joewa/open-bldc-hardware/strip/v0.2/pictures/strip_V02-bottom.jpg

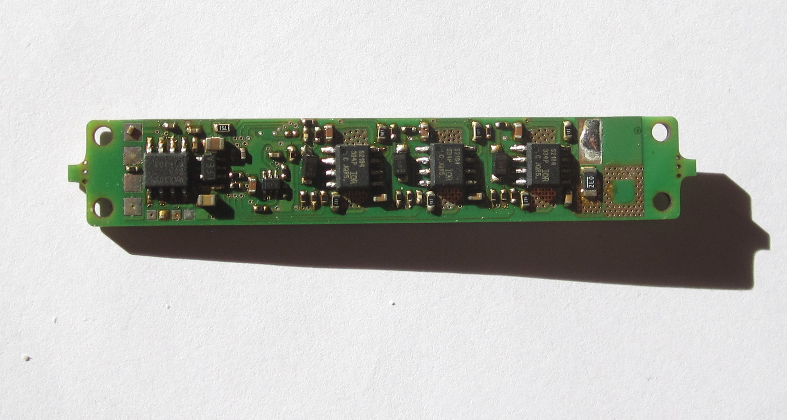
strip/v0.2/pictures/strip_V02-bottom.jpg
