joewa/open-bldc-hardware/strip/v0.2/strip.brd

## EAGLE design strip/v0.2/strip.brd (2014-05-27)

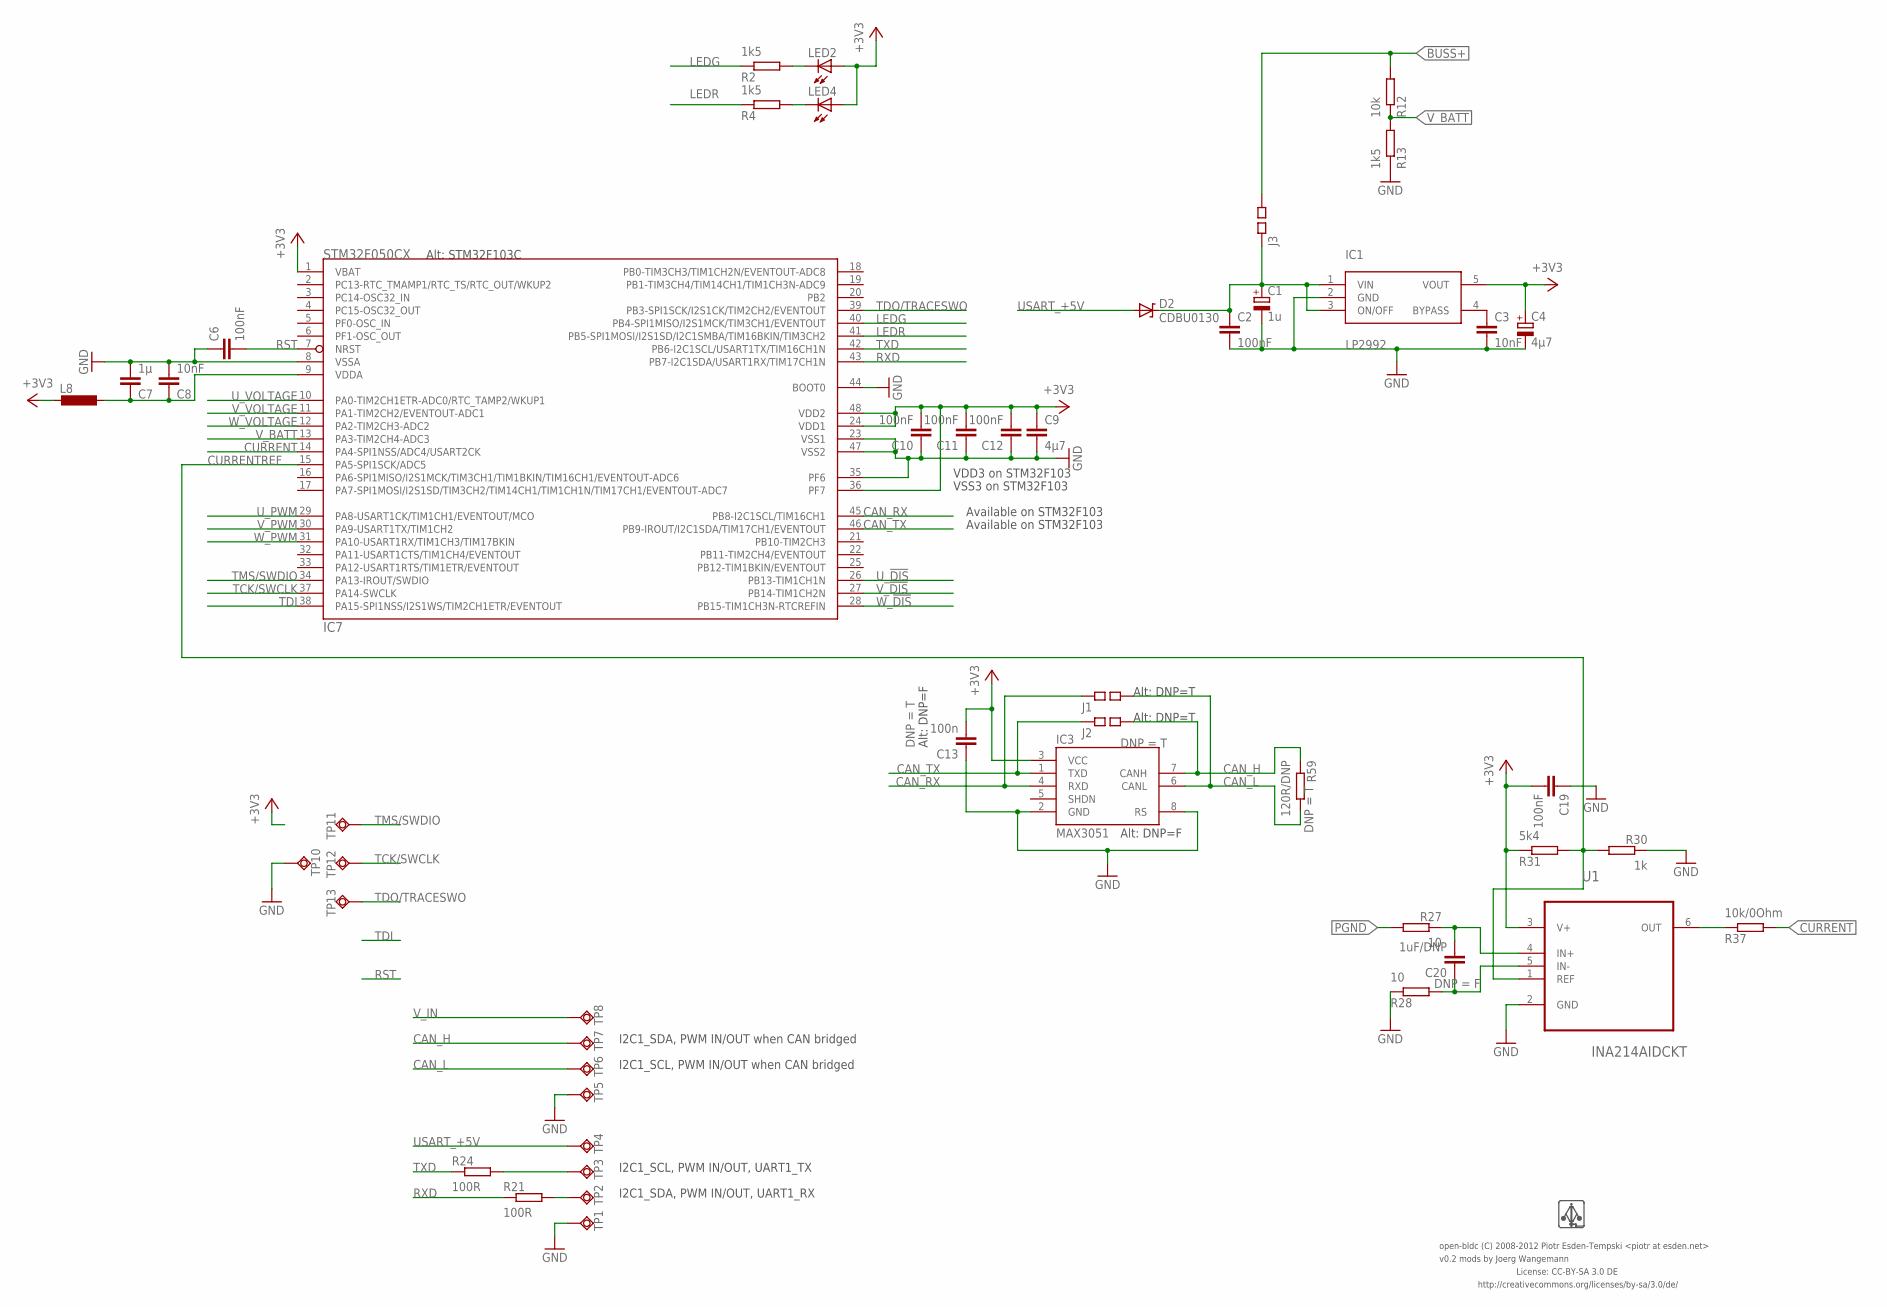
[picture p3: schematic strip.sch, sheet 1]

Parts:
C1: 1u; 0805-POL-CAP; PARTNO cap-cer-0805-1u-35v
C2, C6, C10, C11, C12, C19: 100nF; 0402-CAP; PARTNO cap-cer-0402-100n
C3, C8: 10nF; 0402-CAP; PARTNO cap-cer-0402-10n
C4: 4µ7; 0805-POL-CAP; PARTNO cap-cer-0805-4u7-16v
C7: 1µ; 0402-CAP; PARTNO cap-cer-0402-1u
C9: 4µ7; 0805-CAP; PARTNO cap-cer-0805-4u7
C13: 100n; 0402-CAP; PARTNO cap-cer-0402-100n
C20: 1uF/DNP; 0603-CAP; PARTNO cap-cer-0402-100n
D2: CDBU0130; 0603-DIO; PARTNO diode-0603
IC1: LP2992; SOT23-5; PARTNO vreg-sot-23-5-3v3
IC3: MAX3051; SO8; PARTNO *
IC7: STM32F050CX; LQFP48; PARTNO mcu-tqfp-32-stm32f05
J1, J2, J3: SQ_JMP-0402; 0402-SQJMP; PARTNO res-0402-0
L8: INDUCTOR-0603; 0603-IND; PARTNO ferrite-0603-600ohm
LED2: GREEN; 0402-LED; PARTNO led-0402-green
LED4: RED; 0402-LED; PARTNO led-0402-green
R2, R4, R13: 1k5; 0402-RES; PARTNO res-0402-1k5
R12: 10k; 0402-RES; PARTNO res-0402-10k
R21, R24: 100R; 0402-RES; PARTNO res-0402-100
R27: 10; 0402-RES; PARTNO res-0402-665
R28: 10; 0402-RES; PARTNO res-0402-560
R30: 1k; 0402-RES; PARTNO res-0402-1k
R31: 5k4; 0402-RES; PARTNO res-0402-5k36
R37: 10k/0Ohm; 0402-RES; PARTNO res-0402-0
R59: 120R/DNP; 0402-RES; PARTNO res-0402-60.4
TP1, TP2, TP3, TP4, TP5, TP6, TP7, TP8: TPSQTP20SQ; TP20SQ; PARTNO *
TP10, TP11, TP12, TP13: TPSQTP11SQ; TP11SQ; PARTNO *
U1: INA214AIDCKT; SOT65P210X110-6N
U$1: LOGO; LOGO_SILK_SMALL; PARTNO *

Connections:
+3V3: C4.+, C9.P$1 (1), C10.P$2 (2), C11.P$2 (2), C12.P$2 (2), C13.P$2 (2), C19.P$2 (2), IC1.5 (VOUT), IC3.3 (VCC), IC7.1 (VBAT), IC7.24 (VDD1), IC7.36 (PF7), IC7.48 (VDD2), L8.P$2 (2), LED2.A, LED4.A, R31.P$1 (1), U1.3 (V+)
BUSS+: J3.P$2 (2), R12.P$2 (2); also elsewhere on the board
CAN_H: IC3.7 (CANH), J2.P$2 (2), R59.P$1 (1), TP7.TP
CAN_L: IC3.6 (CANL), J1.P$2 (2), R59.P$2 (2), TP6.TP
CAN_RX: IC3.4 (RXD), IC7.45 (PB8-I2C1SCL/TIM16CH1), J1.P$1 (1)
CAN_TX: IC3.1 (TXD), IC7.46 (PB9-IROUT/I2C1SDA/TIM17CH1/EVENTOUT), J2.P$1 (1)
CURRENT: IC7.14 (PA4-SPI1NSS/ADC4/USART2CK), R37.P$2 (2)
CURRENTREF: IC7.15 (PA5-SPI1SCK/ADC5), R30.P$2 (2), R31.P$2 (2), U1.1 (REF)
CURRENT_RAW: R37.P$1 (1), U1.6 (OUT)
GND: C1.-, C2.P$2 (2), C3.P$2 (2), C4.-, C6.P$1 (1), C7.P$2 (2), C8.P$2 (2), C9.P$2 (2), C10.P$1 (1), C11.P$1 (1), C12.P$1 (1), C13.P$1 (1), C19.P$1 (1), IC1.2 (GND), IC3.2 (GND), IC3.8 (RS), IC7.8 (VSSA), IC7.23 (VSS1), IC7.35 (PF6), IC7.44 (BOOT0), IC7.47 (VSS2), R13.P$1 (1), R28.P$1 (1), R30.P$1 (1), TP1.TP, TP5.TP, TP10.TP, U1.2 (GND); also elsewhere on the board
INA21_INN: C20.P$1 (1), R28.P$2 (2), U1.5 (IN-)
INA21_INP: C20.P$2 (2), R27.P$1 (1), U1.4 (IN+)
LEDG: IC7.40 (PB4-SPI1MISO/I2S1MCK/TIM3CH1/EVENTOUT), R2.P$1 (1)
LEDR: IC7.41 (PB5-SPI1MOSI/I2S1SD/I2C1SMBA/TIM16BKIN/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), R4.P$1 (1)
unnamed: LED4.C, R4.P$2 (2)
unnamed: R21.P$2 (2), TP2.TP
unnamed: LED2.C, R2.P$2 (2)
unnamed: R24.P$2 (2), TP3.TP
unnamed: C3.P$1 (1), IC1.4 (BYPASS)
PGND: R27.P$2 (2); also elsewhere on the board
RST: C6.P$2 (2), IC7.7 (NRST)
RXD: IC7.43 (PB7-I2C1SDA/USART1RX/TIM17CH1N), R21.P$1 (1)
TCK/SWCLK: IC7.37 (PA14-SWCLK), TP12.TP
TDI: IC7.38 (PA15-SPI1NSS/I2S1WS/TIM2CH1ETR/EVENTOUT)
TDO/TRACESWO: IC7.39 (PB3-SPI1SCK/I2S1CK/TIM2CH2/EVENTOUT), TP13.TP
TMS/SWDIO: IC7.34 (PA13-IROUT/SWDIO), TP11.TP
TXD: IC7.42 (PB6-I2C1SCL/USART1TX/TIM16CH1N), R24.P$1 (1)
USART_+5V: D2.A, TP4.TP
U_!DIS: IC7.26 (PB13-TIM1CH1N); also elsewhere on the board
U_PWM: IC7.29 (PA8-USART1CK/TIM1CH1/EVENTOUT/MCO); also elsewhere on the board
U_VOLTAGE: IC7.10 (PA0-TIM2CH1ETR-ADC0/RTC_TAMP2/WKUP1); also elsewhere on the board
VDDA: C7.P$1 (1), C8.P$1 (1), IC7.9 (VDDA), L8.P$1 (1)
V_!DIS: IC7.27 (PB14-TIM1CH2N); also elsewhere on the board
V_BATT: IC7.13 (PA3-TIM2CH4-ADC3), R12.P$1 (1), R13.P$2 (2)
V_IN: C1.+, C2.P$1 (1), D2.C, IC1.1 (VIN), IC1.3 (ON/OFF), J3.P$1 (1), TP8.TP
V_PWM: IC7.30 (PA9-USART1TX/TIM1CH2); also elsewhere on the board
V_VOLTAGE: IC7.11 (PA1-TIM2CH2/EVENTOUT-ADC1); also elsewhere on the board
W_!DIS: IC7.28 (PB15-TIM1CH3N-RTCREFIN); also elsewhere on the board
W_PWM: IC7.31 (PA10-USART1RX/TIM1CH3/TIM17BKIN); also elsewhere on the board
W_VOLTAGE: IC7.12 (PA2-TIM2CH3-ADC2); also elsewhere on the board

Notes on the sheet:
License: CC-BY-SA 3.0 DE
http://creativecommons.org/licenses/by-sa/3.0/de/
open-bldc (C) 2008-2012 Piotr Esden-Tempski <piotr at esden.net>
VDD3 on STM32F103
VSS3 on STM32F103
Available on STM32F103
Alt: STM32F103C
Alt: DNP=T
Alt: DNP=F
I2C1_SDA, PWM IN/OUT when CAN bridged
I2C1_SCL, PWM IN/OUT when CAN bridged
I2C1_SCL, PWM IN/OUT, UART1_TX
I2C1_SDA, PWM IN/OUT, UART1_RX
v0.2 mods by Joerg Wangemann

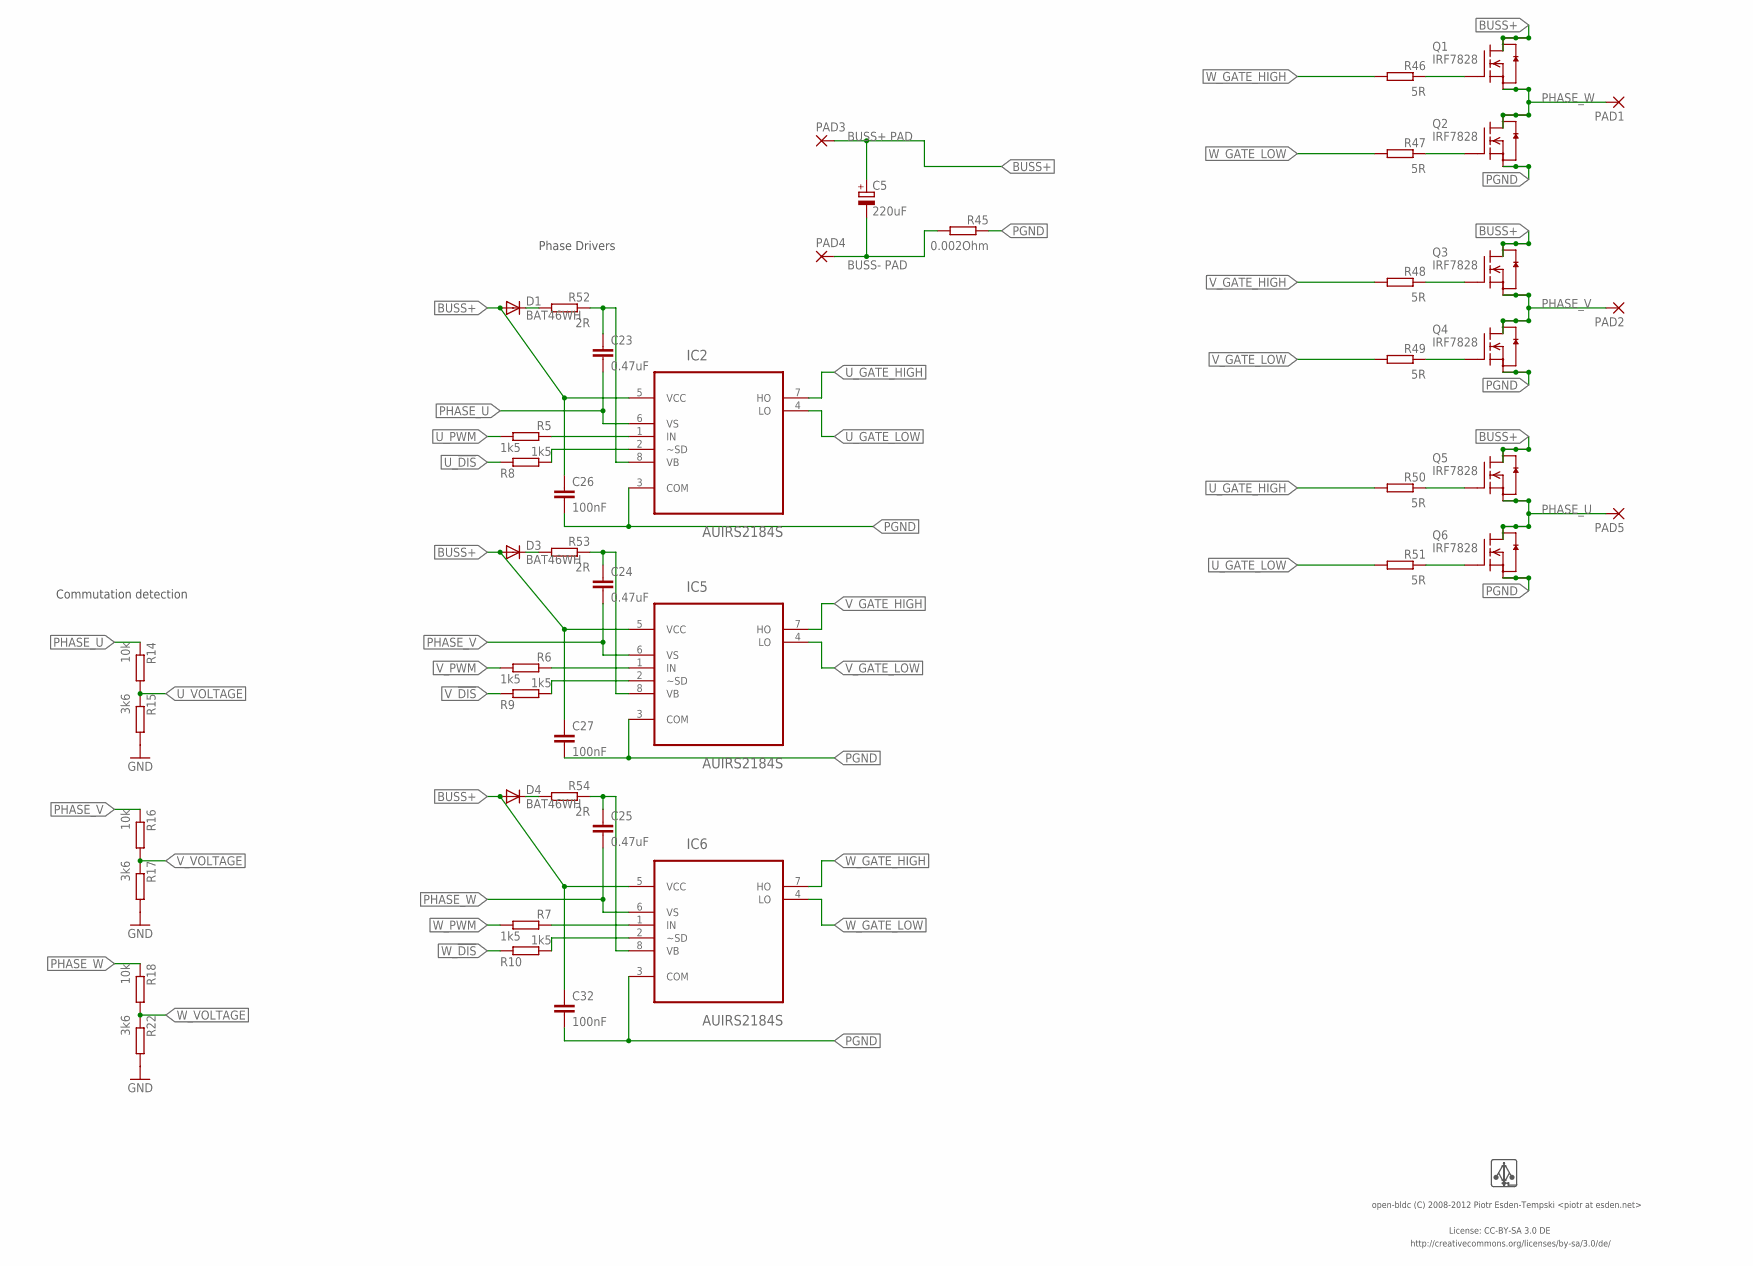
[picture p4: schematic strip.sch, sheet 2]

Parts:
C5: 220uF; 7343/D; PARTNO cap-tan-D-220u-16v
C23, C24, C25: 0.47uF; 0603-CAP; PARTNO cap-tan-0603-1u
C26, C27, C32: 100nF; 0603-CAP; PARTNO cap-cer-0402-100n
D1, D3, D4: BAT46WH; SOD-123-DIO; PARTNO *
IC2, IC5, IC6: AUIRS2184S; SOIC127P600X175-8N; PARTNO ic-so8-mosfet-driver-buck
PAD1, PAD2, PAD3, PAD4, PAD5: SMD5; SMD2,54-5,08; PARTNO *
Q1, Q2, Q3, Q4, Q5, Q6: IRF7828; SO8; PARTNO ic-so8-mosfet-n-ch-30v-15a
R5, R6, R7, R8, R9, R10: 1k5; 0402-RES; PARTNO res-0402-1k5
R14, R16, R18: 10k; 0402-RES; PARTNO res-0402-10k
R15, R17, R22: 3k6; 0402-RES; PARTNO *
R45: 0.002Ohm; 1206-RES; PARTNO res-1206-0005
R46, R47, R48, R49, R50, R51: 5R; 0603-RES; PARTNO res-0402-10
R52, R53, R54: 2R; 0402-RES; PARTNO res-0402-10
U$2: LOGO; LOGO_SILK_SMALL; PARTNO *

Connections:
BUSS+: C5.+, C26.P$1 (1), C27.P$1 (1), C32.P$1 (1), D1.A, D3.A, D4.A, IC2.5 (VCC), IC5.5 (VCC), IC6.5 (VCC), PAD3.1, Q1.5 (D1), Q1.6 (D2), Q1.7 (D3), Q1.8 (D4), Q3.5 (D1), Q3.6 (D2), Q3.7 (D3), Q3.8 (D4), Q5.5 (D1), Q5.6 (D2), Q5.7 (D3), Q5.8 (D4); also elsewhere on the board
GND: C5.-, PAD4.1, R15.P$2 (2), R17.P$2 (2), R22.P$2 (2), R45.P$2 (2); also elsewhere on the board
unnamed: D1.C, R52.P$2 (2)
unnamed: D4.C, R54.P$2 (2)
unnamed: D3.C, R53.P$2 (2)
PGND: C26.P$2 (2), C27.P$2 (2), C32.P$2 (2), IC2.3 (COM), IC5.3 (COM), IC6.3 (COM), Q2.1 (S3), Q2.2 (S2), Q2.3 (S1), Q4.1 (S3), Q4.2 (S2), Q4.3 (S1), Q6.1 (S3), Q6.2 (S2), Q6.3 (S1), R45.P$1 (1); also elsewhere on the board
PHASE_U: C23.P$2 (2), IC2.6 (VS), PAD5.1, Q5.1 (S3), Q5.2 (S2), Q5.3 (S1), Q6.5 (D1), Q6.6 (D2), Q6.7 (D3), Q6.8 (D4), R14.P$1 (1)
PHASE_V: C24.P$2 (2), IC5.6 (VS), PAD2.1, Q3.1 (S3), Q3.2 (S2), Q3.3 (S1), Q4.5 (D1), Q4.6 (D2), Q4.7 (D3), Q4.8 (D4), R16.P$1 (1)
PHASE_W: C25.P$2 (2), IC6.6 (VS), PAD1.1, Q1.1 (S3), Q1.2 (S2), Q1.3 (S1), Q2.5 (D1), Q2.6 (D2), Q2.7 (D3), Q2.8 (D4), R18.P$1 (1)
U_!DIS: R8.P$1 (1); also elsewhere on the board
U_GATE_HIGH: IC2.7 (HO), R50.P$2 (2)
U_GATE_HIGH_T: Q5.4 (G), R50.P$1 (1)
U_GATE_LOW: IC2.4 (LO), R51.P$2 (2)
U_GATE_LOW_T: Q6.4 (G), R51.P$1 (1)
U_PWM: R5.P$2 (2); also elsewhere on the board
U_PWM_IN: IC2.1 (IN), R5.P$1 (1)
U_SD: IC2.2 (~SD), R8.P$2 (2)
U_VB: C23.P$1 (1), IC2.8 (VB), R52.P$1 (1)
U_VOLTAGE: R14.P$2 (2), R15.P$1 (1); also elsewhere on the board
V_!DIS: R9.P$1 (1); also elsewhere on the board
V_GATE_HIGH: IC5.7 (HO), R48.P$2 (2)
V_GATE_HIGH_T: Q3.4 (G), R48.P$1 (1)
V_GATE_LOW: IC5.4 (LO), R49.P$2 (2)
V_GATE_LOW_T: Q4.4 (G), R49.P$1 (1)
V_PWM: R6.P$2 (2); also elsewhere on the board
V_PWM_IN: IC5.1 (IN), R6.P$1 (1)
V_SD: IC5.2 (~SD), R9.P$2 (2)
V_VB: C24.P$1 (1), IC5.8 (VB), R53.P$1 (1)
V_VOLTAGE: R16.P$2 (2), R17.P$1 (1); also elsewhere on the board
W_!DIS: R10.P$1 (1); also elsewhere on the board
W_GATE_HIGH: IC6.7 (HO), R46.P$2 (2)
W_GATE_HIGH_T: Q1.4 (G), R46.P$1 (1)
W_GATE_LOW: IC6.4 (LO), R47.P$2 (2)
W_GATE_LOW_T: Q2.4 (G), R47.P$1 (1)
W_PWM: R7.P$2 (2); also elsewhere on the board
W_PWM_IN: IC6.1 (IN), R7.P$1 (1)
W_SD: IC6.2 (~SD), R10.P$2 (2)
W_VB: C25.P$1 (1), IC6.8 (VB), R54.P$1 (1)
W_VOLTAGE: R18.P$2 (2), R22.P$1 (1); also elsewhere on the board

Notes on the sheet:
Phase Drivers
Commutation detection
BUSS+ PAD
BUSS- PAD
License: CC-BY-SA 3.0 DE
http://creativecommons.org/licenses/by-sa/3.0/de/
open-bldc (C) 2008-2012 Piotr Esden-Tempski <piotr at esden.net>

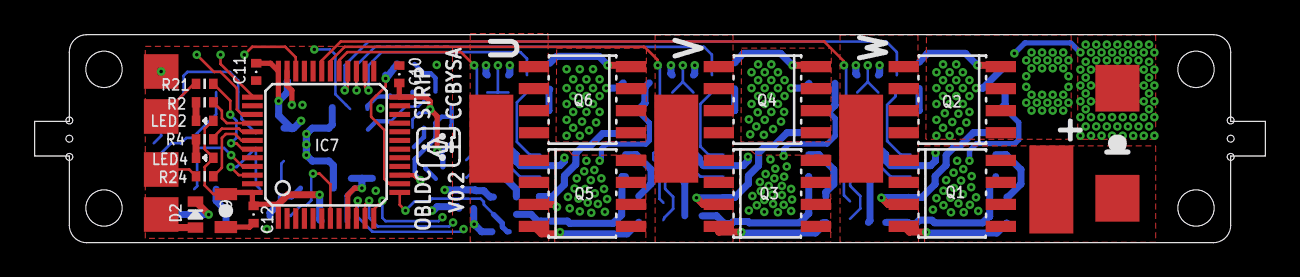
[picture p5: board strip.brd from above]

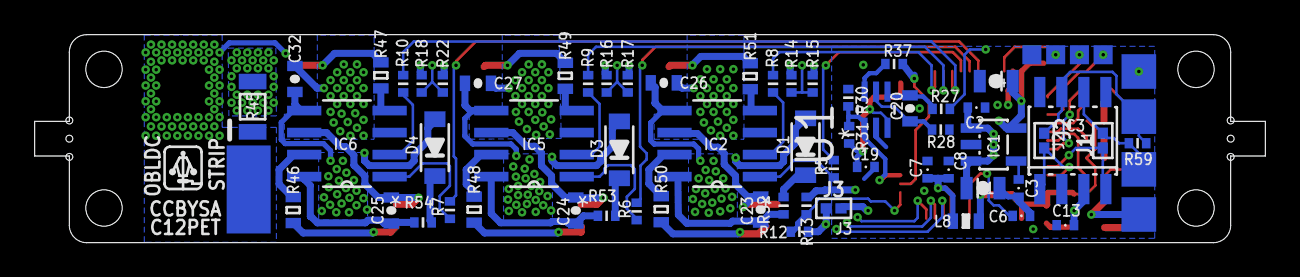
[picture p6: board strip.brd from below]

Board: 4 copper layers, 71.0 x 12.0 mm, 97 parts (69 on the bottom side), 66 nets.
