joewa/open-bldc-hardware/v0.3/power_hv/power.brd

## EAGLE design v0.3/power_hv/power.brd (2013-10-07)

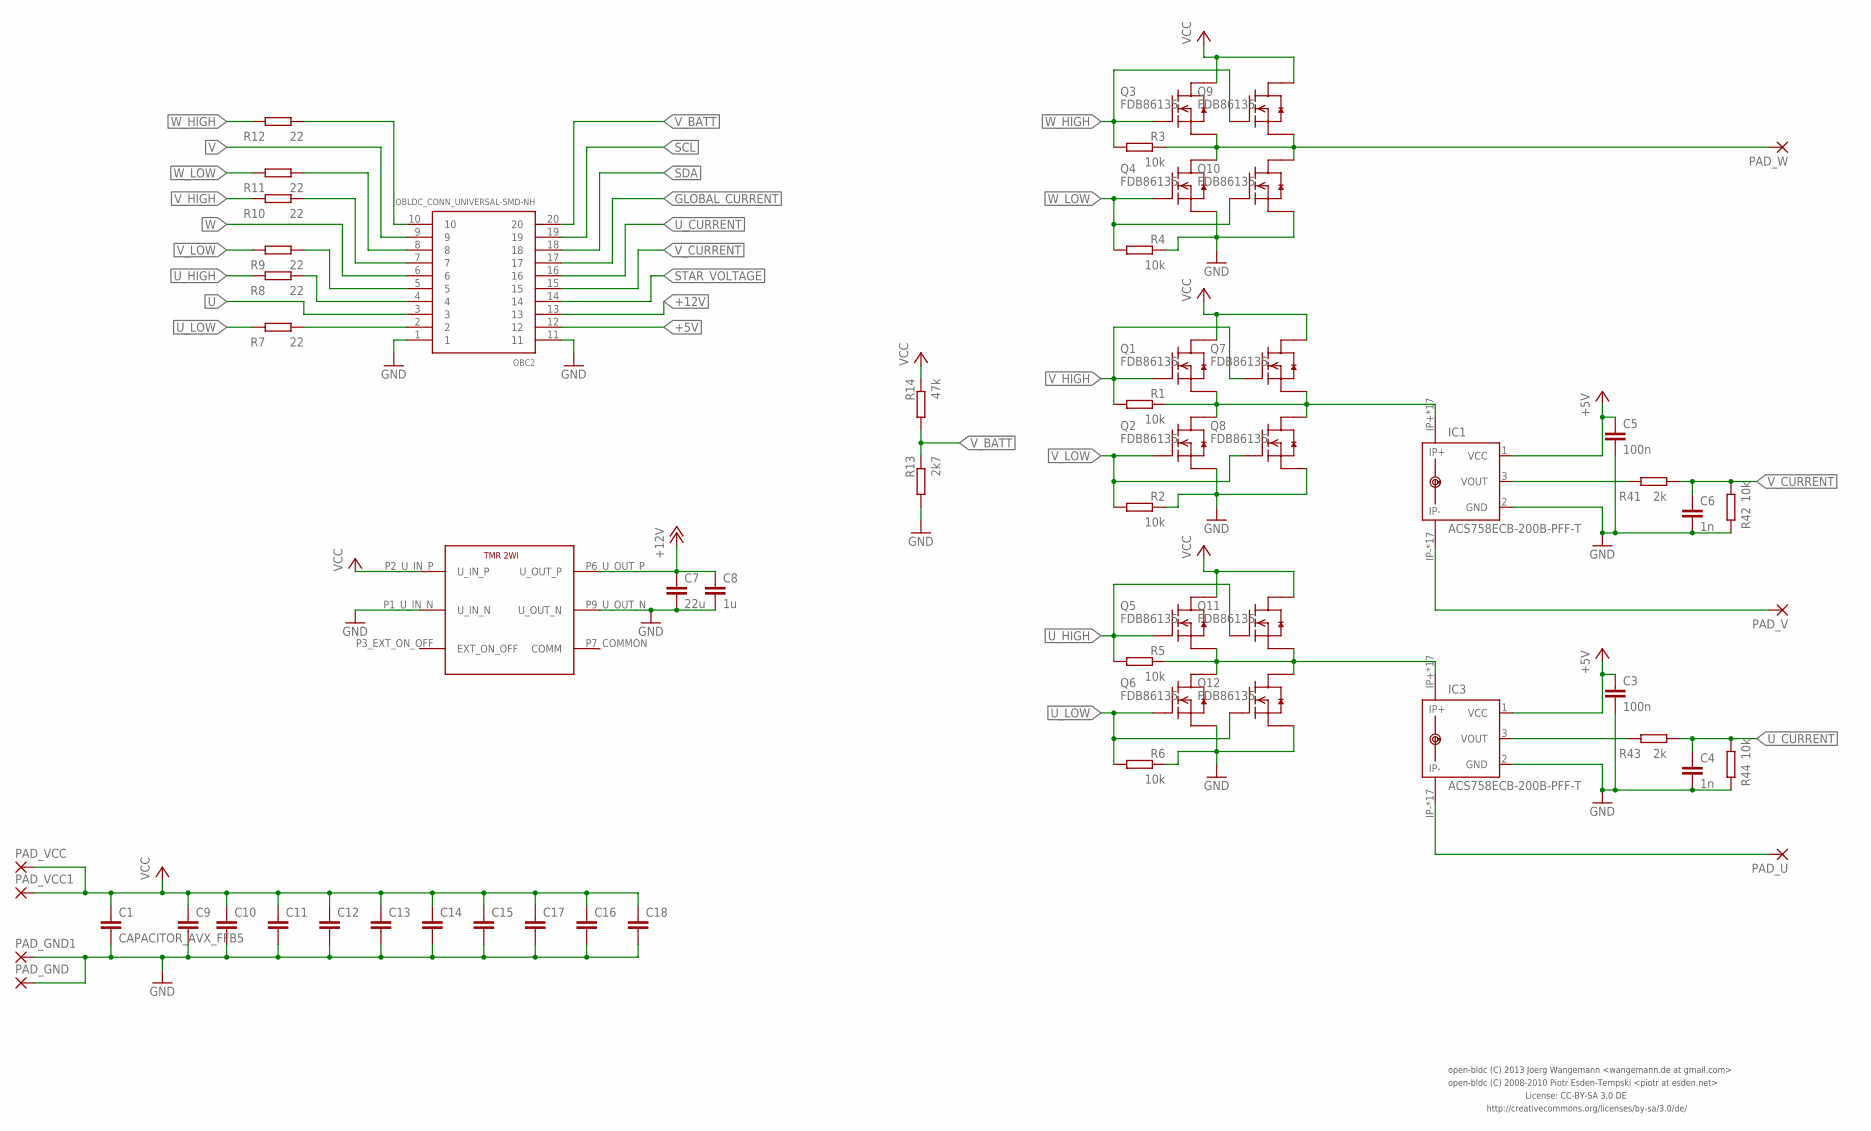
[picture p7: schematic power.sch]

Parts:
C1: CAPACITOR_AVX_FFB5; AVX_FFB5
C3, C5: 100n; 0603-CAP
C4, C6: 1n; 0603-CAP
C7: 22u; C2220K
C8: 1u; C1206
C9, C10, C11, C12, C13, C14, C15, C16, C17, C18: C-EUC2220K; C2220K
IC1, IC3: ACS758ECB-200B-PFF-T; CB-PFF
OBC2: OBLDC_CONN_UNIVERSAL-SMD-NH; OBLDC_CONN_SMD_NO_HOLES
PAD_GND, PAD_GND1: WIREPAD-2MM; WIREPAD_2MM
PAD_U: WIREPAD-2MM; WIREPAD_2MM
PAD_V: WIREPAD-2MM; WIREPAD_2MM
PAD_VCC, PAD_VCC1: WIREPAD-2MM; WIREPAD_2MM
PAD_W: WIREPAD-2MM; WIREPAD_2MM
Q1, Q2, Q3, Q4, Q5, Q6, Q7, Q8, Q9, Q10, Q11, Q12: FDB86135; DPAK
R1, R2, R3, R4, R5, R6: 10k; 0603-SF-RES
R7, R8, R9, R10, R11, R12: 22; 1206-RES
R13: 2k7; 1206-RES
R14: 47k; 1206-RES
R41, R43: 2k; 0603-RES
R42, R44: 10k; 0603-RES
U$2: TRACO_TMR_2WI

Connections:
+5V: C3.P$1 (1), C5.P$1 (1), IC1.1 (VCC), IC3.1 (VCC), OBC2.12
+12V: C7.1, C8.1, OBC2.13, U$2.P6_U_OUT_P (U_OUT_P)
GLOBAL_CURRENT: OBC2.17
GND: C1.P$2 (2), C3.P$2 (2), C4.P$2 (2), C5.P$2 (2), C6.P$2 (2), C7.2, C8.2, C9.2, C10.2, C11.2, C12.2, C13.2, C14.2, C15.2, C16.2, C17.2, C18.2, IC1.2 (GND), IC3.2 (GND), OBC2.1, OBC2.11, PAD_GND.1, PAD_GND1.1, Q2.3 (S), Q4.3 (S), Q6.3 (S), Q8.3 (S), Q10.3 (S), Q12.3 (S), R2.1, R4.1, R6.1, R13.P$2 (2), R42.P$2 (2), R44.P$2 (2), U$2.P1_U_IN_N (U_IN_N), U$2.P9_U_OUT_N (U_OUT_N)
unnamed: IC1.3 (VOUT), R41.P$2 (2)
unnamed: OBC2.2, R7.P$1 (1)
unnamed: OBC2.4, R8.P$1 (1)
unnamed: OBC2.5, R9.P$1 (1)
unnamed: OBC2.7, R10.P$1 (1)
unnamed: OBC2.8, R11.P$1 (1)
unnamed: OBC2.10, R12.P$1 (1)
unnamed: IC3.3 (VOUT), R43.P$2 (2)
SCL: OBC2.19
SDA: OBC2.18
STAR_VOLTAGE: OBC2.14
U: IC3.IP+, IC3.IP+@2 (IP+), IC3.IP+@3 (IP+), IC3.IP+@4 (IP+), IC3.IP+@5 (IP+), IC3.IP+@6 (IP+), IC3.IP+@7 (IP+), IC3.IP+@8 (IP+), IC3.IP+@9 (IP+), IC3.IP+@10 (IP+), IC3.IP+@11 (IP+), IC3.IP+@12 (IP+), IC3.IP+@13 (IP+), IC3.IP+@14 (IP+), IC3.IP+@15 (IP+), IC3.IP+@16 (IP+), IC3.IP+@17 (IP+), OBC2.3, Q5.3 (S), Q6.P$1 (D), Q11.3 (S), Q12.P$1 (D), R5.1
U_CURRENT: C4.P$1 (1), OBC2.16, R43.P$1 (1), R44.P$1 (1)
U_HIGH: Q5.1 (G), Q11.1 (G), R5.2, R8.P$2 (2)
U_LOW: Q6.1 (G), Q12.1 (G), R6.2, R7.P$2 (2)
U_PAD: IC3.IP-, IC3.IP-@2 (IP-), IC3.IP-@3 (IP-), IC3.IP-@4 (IP-), IC3.IP-@5 (IP-), IC3.IP-@6 (IP-), IC3.IP-@7 (IP-), IC3.IP-@8 (IP-), IC3.IP-@9 (IP-), IC3.IP-@10 (IP-), IC3.IP-@11 (IP-), IC3.IP-@12 (IP-), IC3.IP-@13 (IP-), IC3.IP-@14 (IP-), IC3.IP-@15 (IP-), IC3.IP-@16 (IP-), IC3.IP-@17 (IP-), PAD_U.1
V: IC1.IP+, IC1.IP+@2 (IP+), IC1.IP+@3 (IP+), IC1.IP+@4 (IP+), IC1.IP+@5 (IP+), IC1.IP+@6 (IP+), IC1.IP+@7 (IP+), IC1.IP+@8 (IP+), IC1.IP+@9 (IP+), IC1.IP+@10 (IP+), IC1.IP+@11 (IP+), IC1.IP+@12 (IP+), IC1.IP+@13 (IP+), IC1.IP+@14 (IP+), IC1.IP+@15 (IP+), IC1.IP+@16 (IP+), IC1.IP+@17 (IP+), OBC2.9, Q1.3 (S), Q2.P$1 (D), Q7.3 (S), Q8.P$1 (D), R1.1
VCC: C1.P$1 (1), C9.1, C10.1, C11.1, C12.1, C13.1, C14.1, C15.1, C16.1, C17.1, C18.1, PAD_VCC.1, PAD_VCC1.1, Q1.P$1 (D), Q3.P$1 (D), Q5.P$1 (D), Q7.P$1 (D), Q9.P$1 (D), Q11.P$1 (D), R14.P$1 (1), U$2.P2_U_IN_P (U_IN_P)
V_BATT: OBC2.20, R13.P$1 (1), R14.P$2 (2)
V_CURRENT: C6.P$1 (1), OBC2.15, R41.P$1 (1), R42.P$1 (1)
V_HIGH: Q3.1 (G), Q9.1 (G), R3.2, R10.P$2 (2)
V_LOW: Q4.1 (G), Q10.1 (G), R4.2, R9.P$2 (2)
V_PAD: IC1.IP-, IC1.IP-@2 (IP-), IC1.IP-@3 (IP-), IC1.IP-@4 (IP-), IC1.IP-@5 (IP-), IC1.IP-@6 (IP-), IC1.IP-@7 (IP-), IC1.IP-@8 (IP-), IC1.IP-@9 (IP-), IC1.IP-@10 (IP-), IC1.IP-@11 (IP-), IC1.IP-@12 (IP-), IC1.IP-@13 (IP-), IC1.IP-@14 (IP-), IC1.IP-@15 (IP-), IC1.IP-@16 (IP-), IC1.IP-@17 (IP-), PAD_V.1
W: OBC2.6, PAD_W.1, Q3.3 (S), Q4.P$1 (D), Q9.3 (S), Q10.P$1 (D), R3.1
W_HIGH: Q1.1 (G), Q7.1 (G), R1.2, R12.P$2 (2)
W_LOW: Q2.1 (G), Q8.1 (G), R2.2, R11.P$2 (2)

Notes on the sheet:
License: CC-BY-SA 3.0 DE
http://creativecommons.org/licenses/by-sa/3.0/de/
open-bldc (C) 2008-2010 Piotr Esden-Tempski <piotr at esden.net>
open-bldc (C) 2013 Joerg Wangemann <wangemann.de at gmail.com>

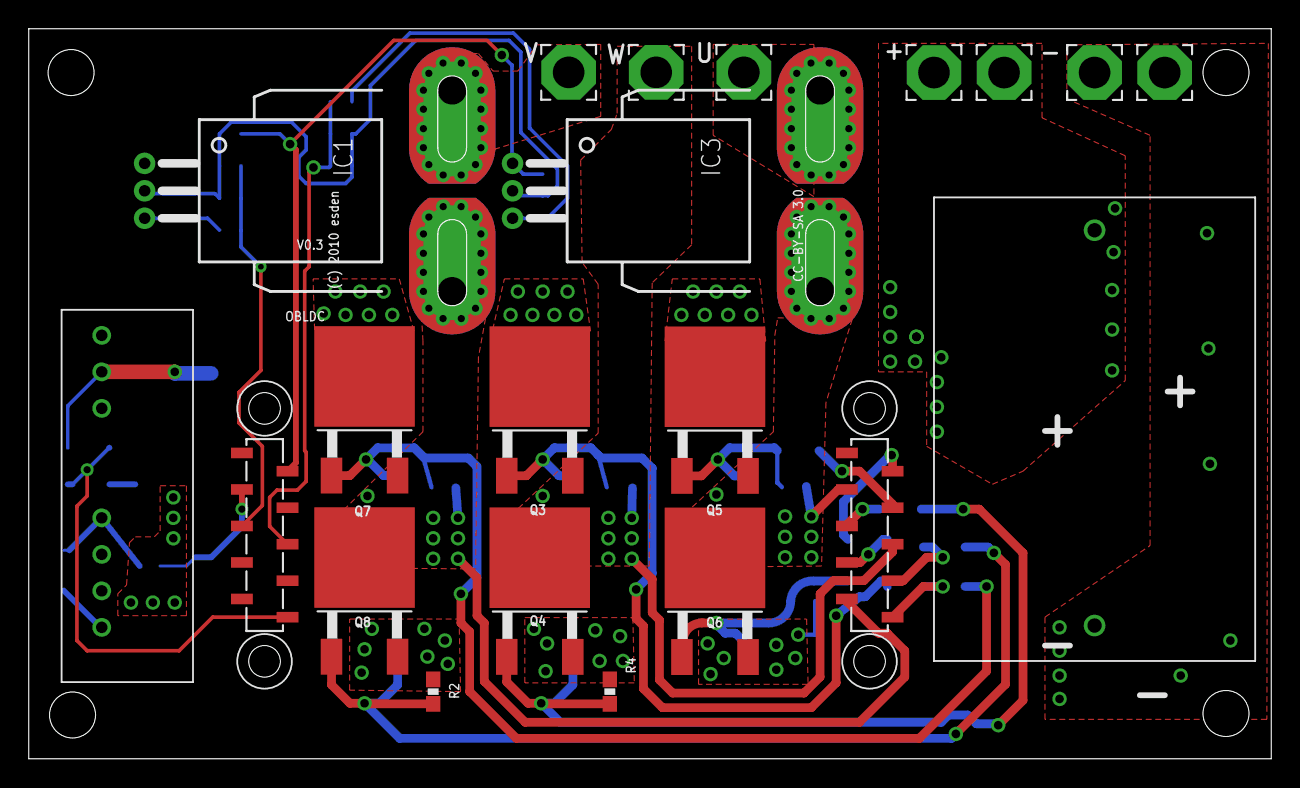
[picture p8: board power.brd from above]

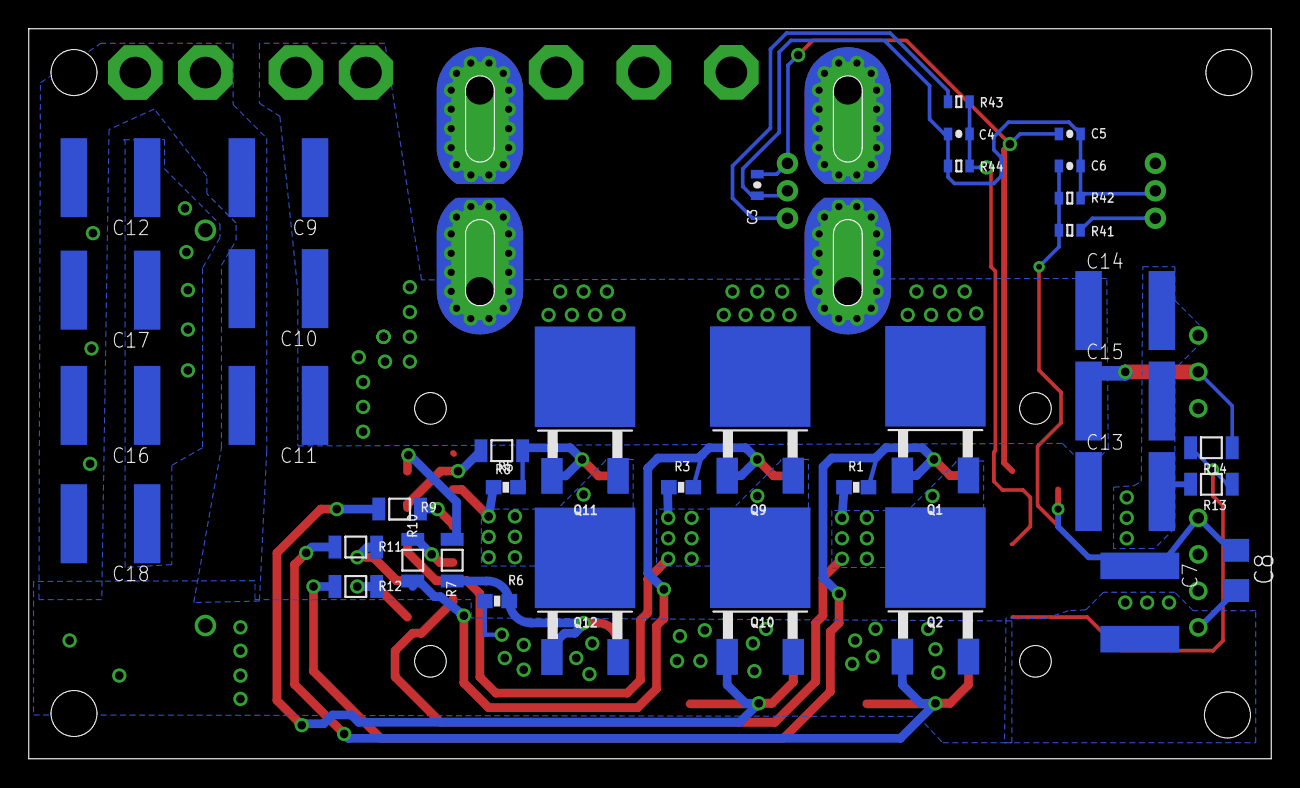
[picture p9: board power.brd from below]

Board: 4 copper layers, 86.5 x 50.8 mm, 59 parts (38 on the bottom side), 26 nets.

Other parts of the board:
U$1: OBLDC_MECH
