joewa/open-bldc-hardware/strip/v0.2/strip_changelog.txt

Changelog of the Open-BLDC "Strip" board

v0.2
Replaced 12V gate driver IC by a 20V type (IRS2184S).
It should be possible to operate with 14.8V (4S) or even 5S if we are lucky.
Redesign of the current measurement circuit.
