joewa/open-bldc-hardware/(commit log)

2013-10-06 Added the new high voltage power board.
    [power.brd, power.sch]
2013-10-07 TODO: Route ground connection to driver board.
    [power.brd, power.sch]
2013-10-12 Added some notes on the power stage power_hv v.0.3.
2013-10-22 Added new variant of the strip board.
    [layout.cfg, rail.brd, rail.sch, strip.brd, strip.sch]
2013-10-23 Updated bootstrap circuit.
    [strip.brd, strip.sch]
2013-10-23 Updated bootstrap circuit
    [strip.brd, strip.sch]
2013-10-24 Updated current measurement circuit.
    [strip.brd, strip.sch]
2013-10-25 Wired the layout of the new current measurement.
    [strip.brd, strip.sch]
2013-10-29 Fixed some part descriptons.
    [strip.brd, strip.sch]
2013-11-08 Strip v0.2 layout after manufacturer review.
    [layout.cfg, strip.brd]
2013-11-28 Corrected some component values.
    [strip.brd, strip.sch]
2014-05-27 Pin COM of the IRS2184 driver is now connected to PGND... as it should.
    [strip.brd, strip.sch]
2015-04-05 Addded some pictures of the board.
