joewa/open-bldc-hardware/(notices)

Notices in the files:
v0.3/power_hv/power.brd:
(C) 2010 esden
